JohnWSatterfield/VFO4.1.1/Documents/Atlas Si5351 VFO Schematic Update.PNG

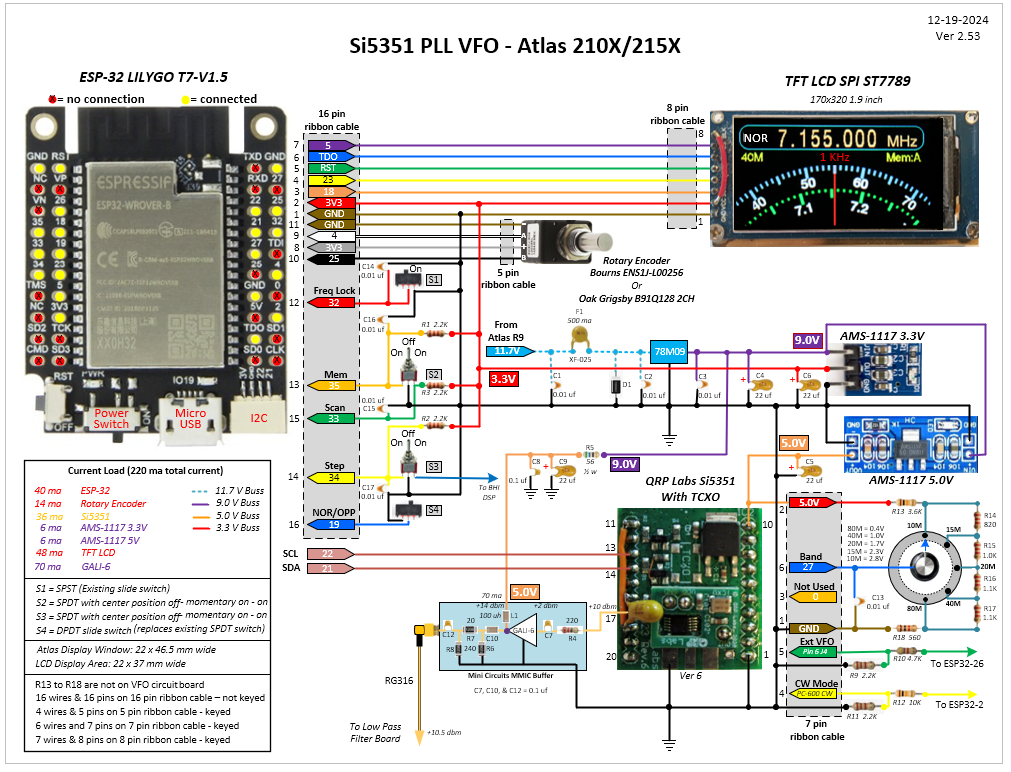
Documents/Atlas Si5351 VFO Schematic Update.PNG
