JohnWSatterfield/VFO4.1.1/Pic/QRP Labs Main LPF Board.jpg

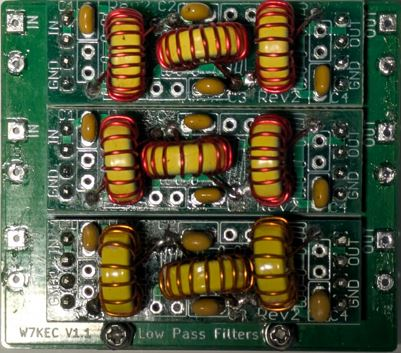
Pic/QRP Labs Main LPF Board.jpg
