JohnWSatterfield/VFO4.1.1/Sketch/VFO Filters.pdf

12V 5V Gnd SKETCH FOR ATLAS 210x FILTERS - 2/05/24 CLK0 CLK1 CLK2 VDD SCLSI5351 module GND SDA VCC Module Regulator 12V TO 5V REG. Vin Vout 270pf C 1.09uh L 560pf C 1.26uh L 560pf C 1.09uh L 270pf C 82pf C 444nh L 220pf C 561uh L 220pf C 444nh L 82pf C 56pf C 303nh L 150pf C 382h L 150pf C 303nh L 56pf C 101112131415Vcc 65432 GND7 DIP 16 1 9 USE ON 80/20m, 40/15m & 10m BANDS LOW PASS FILTERS - 37T-6 TOROID IN GNDIN GNDIN GND GND OUT GND OUT GND OUT 10m BAND 40/15m BANDS 80/20m BANDS P4 - BP CLK0 10m-in 80/20m-in 40/15m-in 10m-IN 40/15m-out MUX1 P6 MUX0 P5 5.0V P11-BP VFO-out 10m-out 80/20m-out 74HCT4052 P15-MUX P14-MUX P12-MUX P2-MUX P5-MUX P1-MUX 3.3V P13-MUX P09-SCL P08-SDA FILTERS FOR ATLAS 210x 40/15m-IN 80/20m-IN GND N/C SCL SDA VCC 3.3V GND Yellow White P09 Yellow P08 White Black RedTINY 12C CLOCK H H Y3 BYPASS L H Y2 10 H L Y1 40/15 L L Y0 80/20 S0 S1 MOX0 MUX1 OUT BAND 28.300 - 22.655 21.300 - 15.655 7.200 - 12.845 3.900 - 9.545 14.250 - 8.605 1 2 11 2 1 2 1 1 MUX 6 7 12 14 Turns L1 L2 10" 10 19 20 Turns L1 L2 1/2" 1/2" 1/2" 5 6" 10 11 Turns L1 L2 1/2" CAR OSC Yellow Red White Red Black White Orange Yellow Red Yellow 2.2 uf .1 uf Yellow FUT INT SCL SDA 3.3V+ GND GND ROTARY SWITCH BAND SELECTOR SDA PFC8574 SCL GND VCC INT P0 P1 P2 P3 P4 P16 (G) White Yellow Black Red Green P8 (W) P9 (Y) 3.3V COM80m 40m 20m 15m10m W G 5" Long O G B R P5 P6 P7 B 74HCT4052 4-CHANNEL MULTIPLEXR Filter Plug Yellow White MUX0 P10MUX1 P9 Black Red Green Orange Yellow White Red Black 3.3V P09-SCL P08-SDA Yellow White P09-SCL P08-SDA NORM SLIDE SWITCH SS-1 OPP SIDEBAND SELECTOR White Wire 40x60 Prototype Bd6 PIN MALE JST 2 PIN MALE JST 2 Pin Male DuPont 16 Pin IC Socket 5 Pin Male DuPont 3 Pin Female DuPont 8 Pin Female DuPont 7 Pin Female DuPont Ceramic Capacitor (12) 37-T6 Toroid (9) 10 K10 K 3.3V
