JohnWSatterfield/VFO4.1.1/Sketch/VFO4.1.1 9.62 C3 Zero.pdf

B 128 p/rev Rotary Enc. GND 1 3 4 2 576 8 OUTSIDE RADIO LOOKING AT SOCKET Internal VFO Radio Ground +9.2 Control In CLK0 To Radio VFO in ESP32-C3 Zero by John Satterfield - KI5IDZ 3.3V 2.0K R GND for software Version VFO4.1.1 04/07/.524 Set Count to 20 9 VFO input to Radio or External VFO in + 9.2V TO 3.3V REG. Vin Vout 9.2V 3.3V Gnd PC-200 Pin 21 - O SKETCH FOR ATLAS 210x DIGITAL VFO (DDS) 3.3V GND 5VESP32-C3 Zero IO07 IO08 IO09 IO10 IO18 IO19 IO20 IO21 IO04 IO02 IO01 IO00 INT (G) SCK (W) TSCL (Y) CS (Bl) MOSI (Y) RS/DC (G) Bottom USB W/O Wire +9.2V VFO (Y) 3.3V To Radio Plug Yellow Yellow Wire Splice BRWY +12V Radio in CW Mode W/Bk Wire Red Wire Splice PC 600 COM NC 5V RELAY1 SIG 5V NO GND RADIO Future R 2.2K GND R 4.7K P01 Red P19 Yellow 10K R P Black (future) BRWY Filter Plug Radio Plug Scan Step Memory GND on (off) on P02 YellowSwitch Plug P04 P20 BRWY P03 Yellow GND Switch Plug P05 Black Red White A Black Red White Black Red White Yellow Black Red White Yellow Future FUT INT SCL SDA 3.3V+ GND GND Red Black Gnd Green Orange Yellow White IO05 IO06 IO03 TSDA(W) Scan (R) LOCK (W) ENC B (Y) Step (W) ENC A (W) MEM (Y) CW+ (R) 3.3V GND LED SCK RES CS VCC 3.3V ST7735 (128X160) TFT LCD 12345678 MOSI P06 P10 3.3V P09 Black Red White Yellow Orange Green Blue Violet 1.77 Inch SCK SDA/MOSI RS/DC CS RS P18 30x70 Prototype Bd (TOP) A B C D E F G H I J K L M N O P Q R S T U V W X9 7 10 5 8 3 6 2 1 4 30x70 Prototype Bd (BOTTOM) A B C D E F G H I J K L M N O P Q R S T U V W X9 7 10 5 8 3 6 2 1 4
