JohnWSatterfield/VFO4.1.1/Documents/10M LPF.JPG

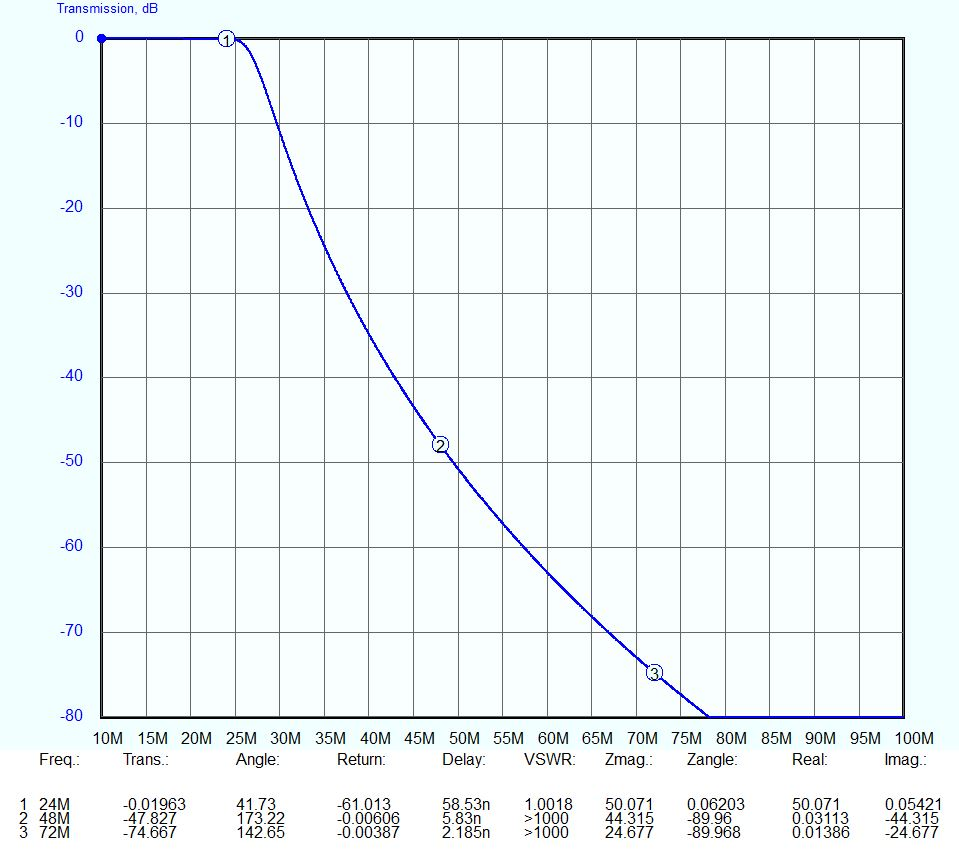
Documents/10M LPF.JPG
