JohnWSatterfield/VFO4.1.1/Documents/40M-15M LPF.JPG

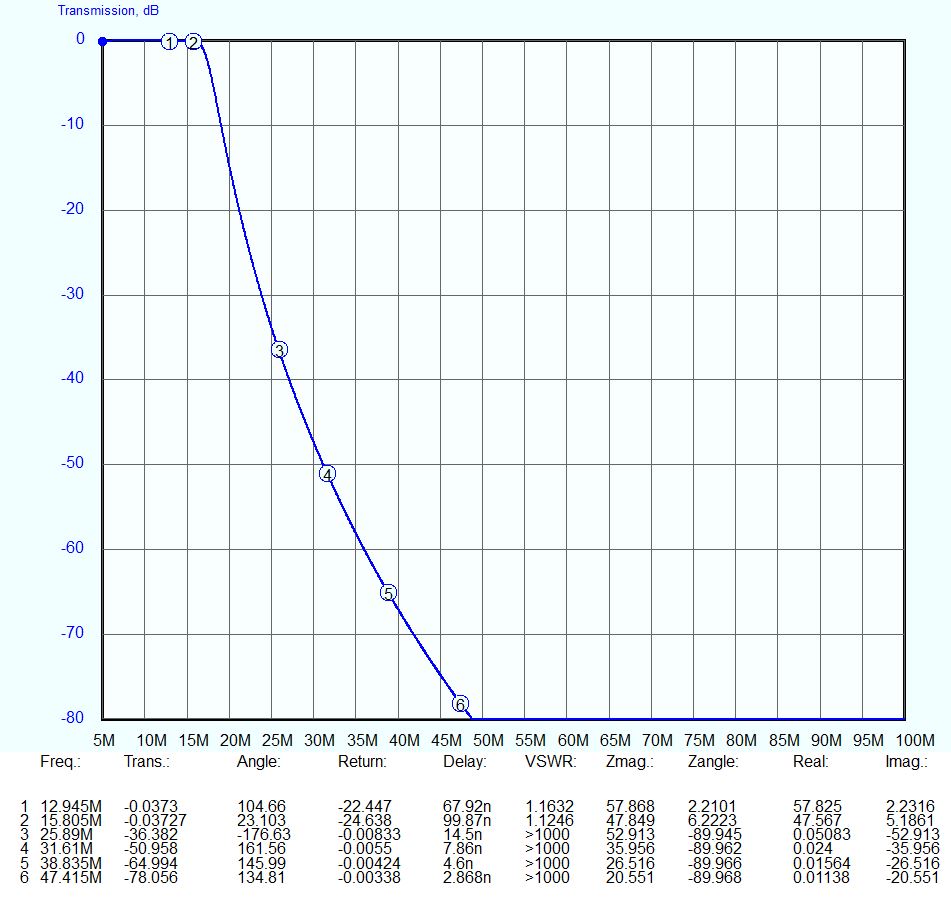
Documents/40M-15M LPF.JPG
