JohnWSatterfield/VFO4.1.1/Documents/160M-80M-20M LPF.JPG

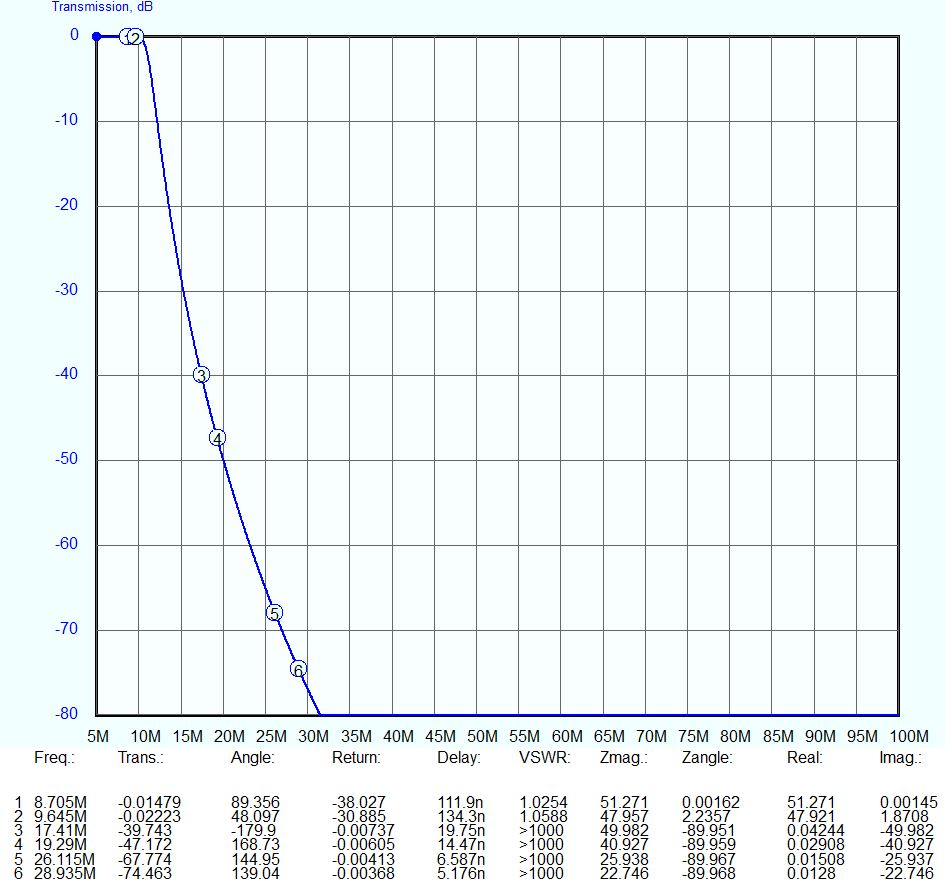
Documents/160M-80M-20M LPF.JPG
