JohnWSatterfield/VFO4.1.1/Pic/210X LE Front Panel Labels.jpg

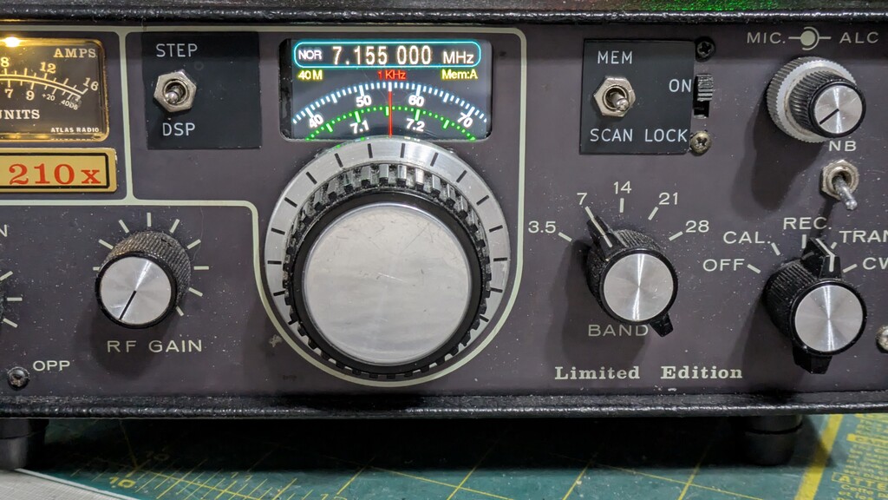
Pic/210X LE Front Panel Labels.jpg
