JohnWSatterfield/VFO4.1.1/Pic/JLCPCB Ciruit Boards.jpg

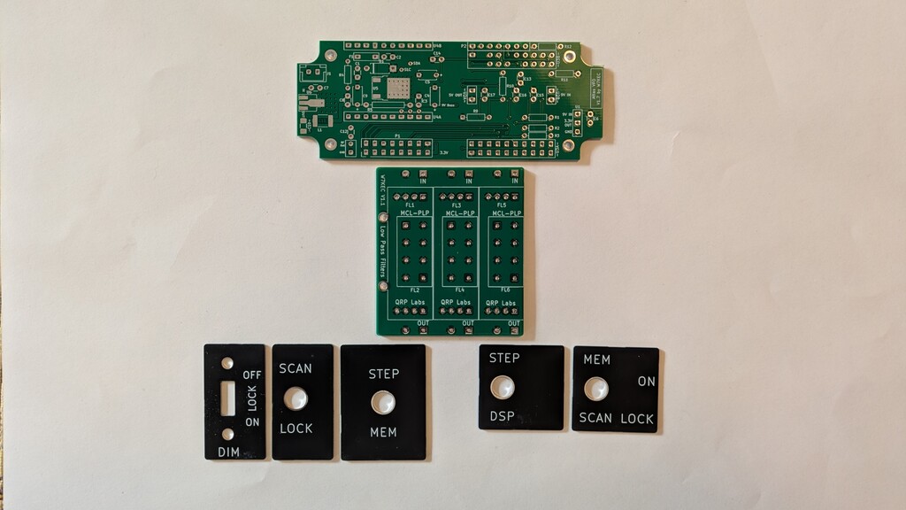
Pic/JLCPCB Ciruit Boards.jpg
