JohnWSatterfield/VFO4.1.1/Sketch/ESP32 D1 Mini.pdf

# CLK0 CLK1

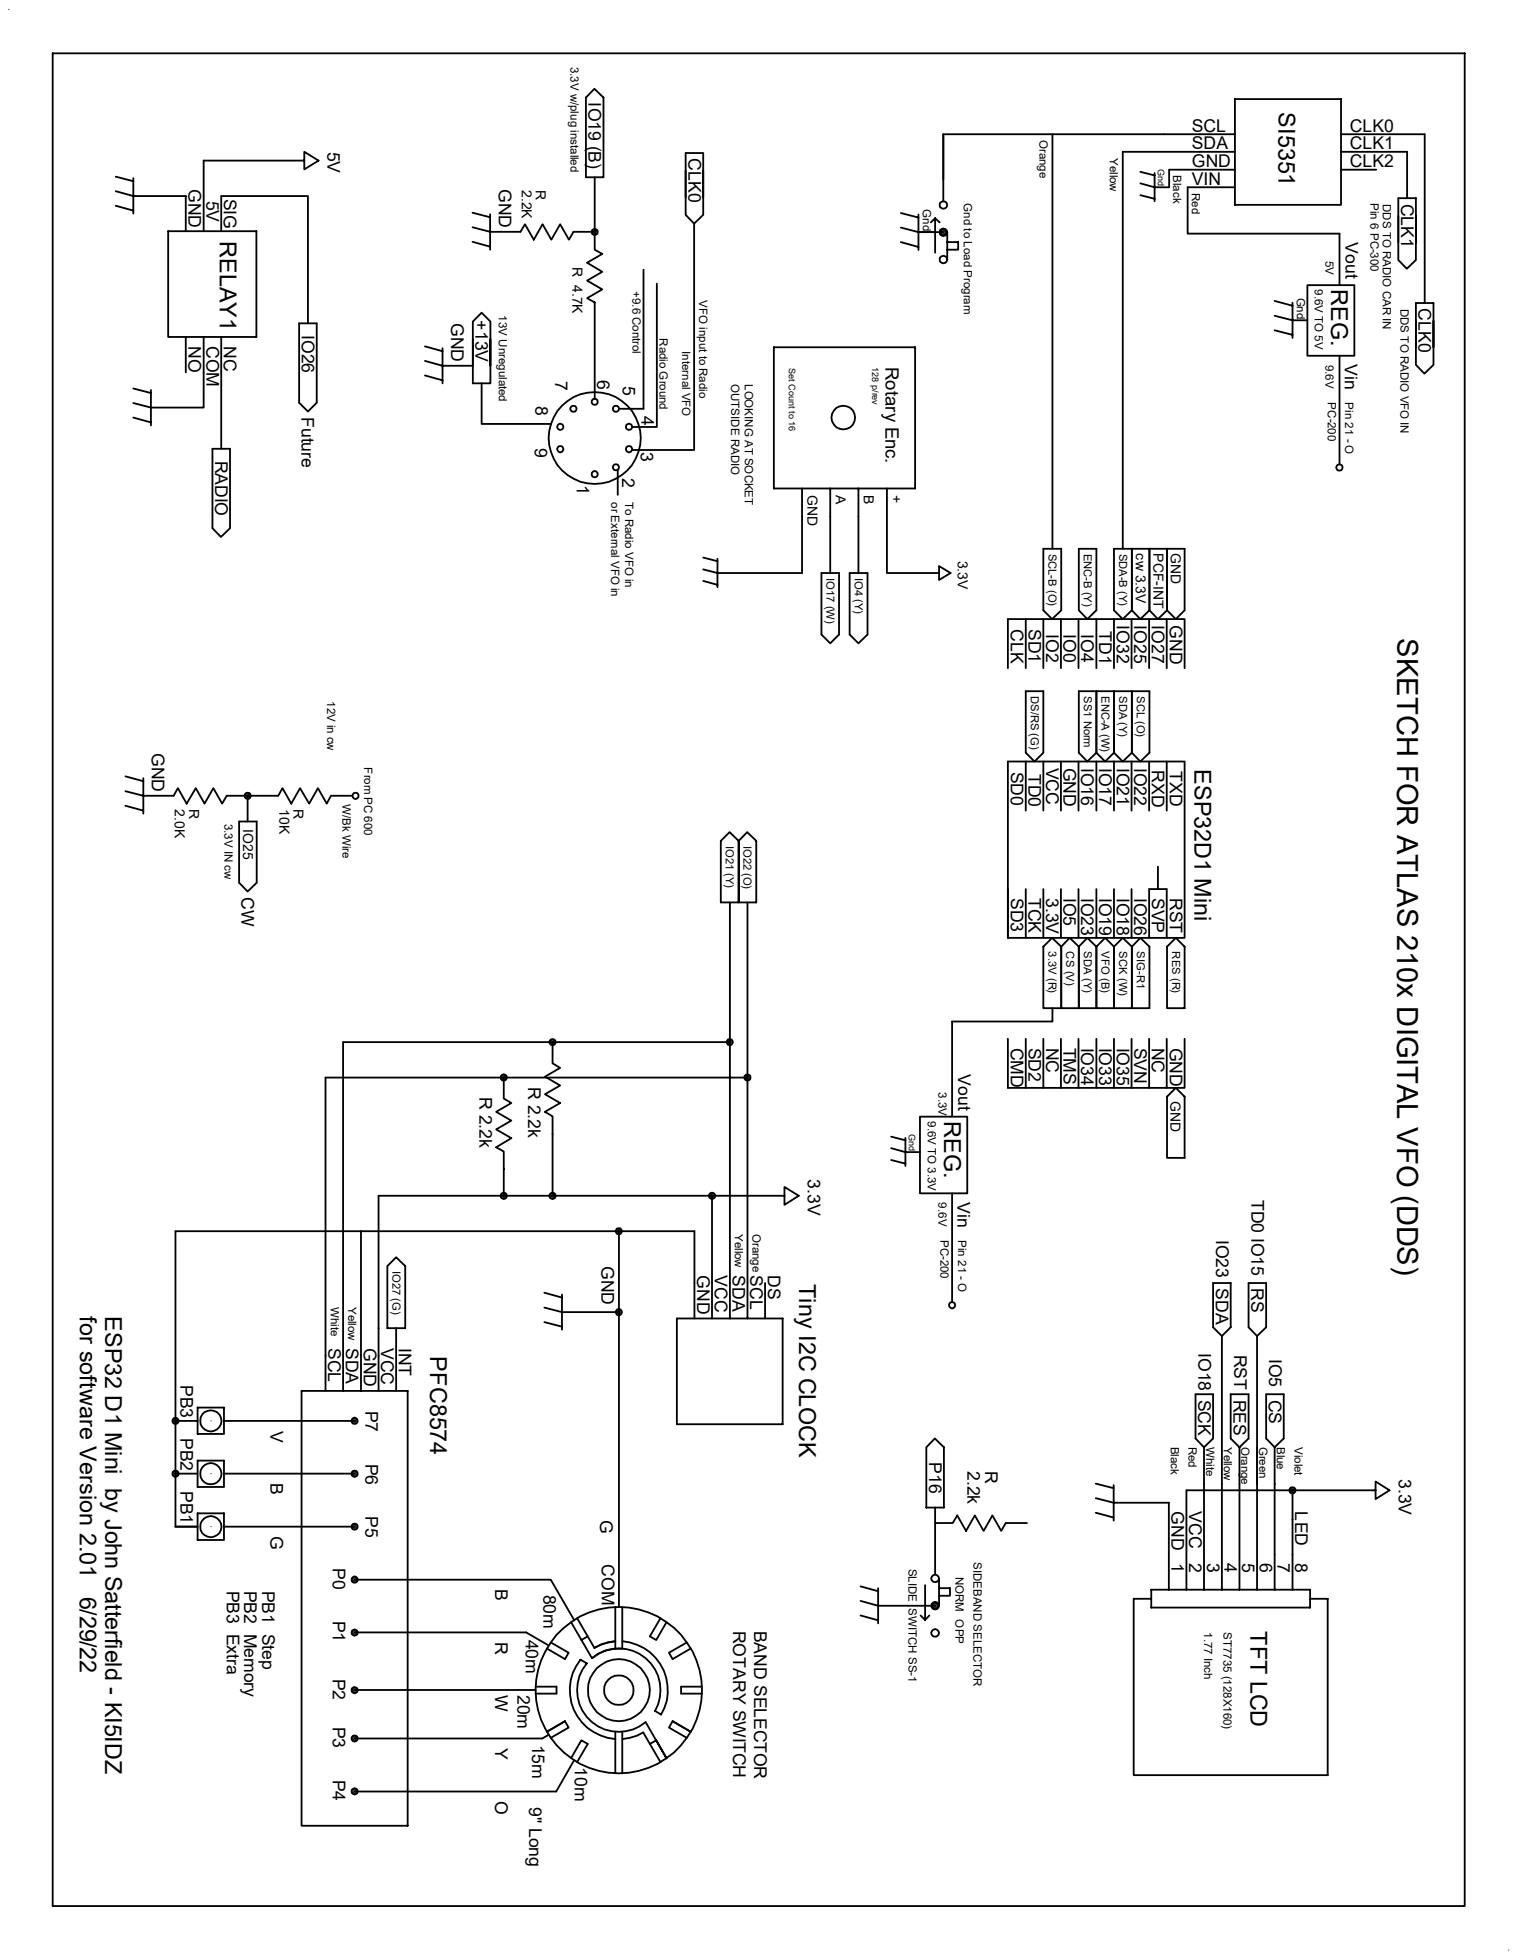
[picture p8: page 1]

8 R 4.7K GND 2.2K R IO19 (B) 3.3V w/plug installed +13V 13V Unregulated GND OUTSIDE RADIO LOOKING AT SOCKET Internal VFO Radio Ground +9.6 Control IO18 IO23 RST TD0 IO15 IO5 GND

8 SDA RS SDA Tiny I2C CLOCK VCC SCL GND COM NC 5V RELAY1 SIG 5V NO IO26 GND RADIO 1

+ Pin 6 PC-300 9.6V TO 3.3V REG. Vin Vout 9.6V 3.3V Gnd PC-200 Pin 21 - O SKETCH FOR ATLAS 210x DIGITAL VFO (DDS) Gnd to Load Program Gnd IO26 SVP RST ESP32D1 Mini Yellow IO27 GND cw 3.3V PCF-INT IO32 IO25 CLK SD1 IO2 IO0 IO4 TD1 SD0 TD0 VCC GND IO16 IO17 IO21 IO22 RXD TXD SD3 TCK 3.3V IO5 IO23 IO19 IO18 CMD SD2 NCTMS IO34 IO33 IO35 SVN NCGND SCL-B (O) SDA-B (Y) GND ENC-A (W) SDA (Y) SCL (O) CS (V) SDA (Y) SCK (W) RES (R) DS/RS (G) GND ENC-B (Y) SS1 Norm 3.3V (R) VFO (B) SIG-R1 Gnd Orange Red Black IO17 (W) IO4 (Y) IO21 (Y) IO22 (O) CW IO27 (G)

9 From PC 600 W/Bk Wire VFO input to Radio or External VFO in 9.6V TO 5V REG. Vin Vout 9.6V 5V Gnd PC-200 Pin 21 - O 2.2k R

B 128 p/rev Rotary Enc. GND LED SCK RES CS VCC 3.3V ST7735 (128X160) TFT LCD
