JohnWSatterfield/VFO4.1.1/Sketch/VFO4.1.1 9.62 RP2040 Zero.pdf

B
R

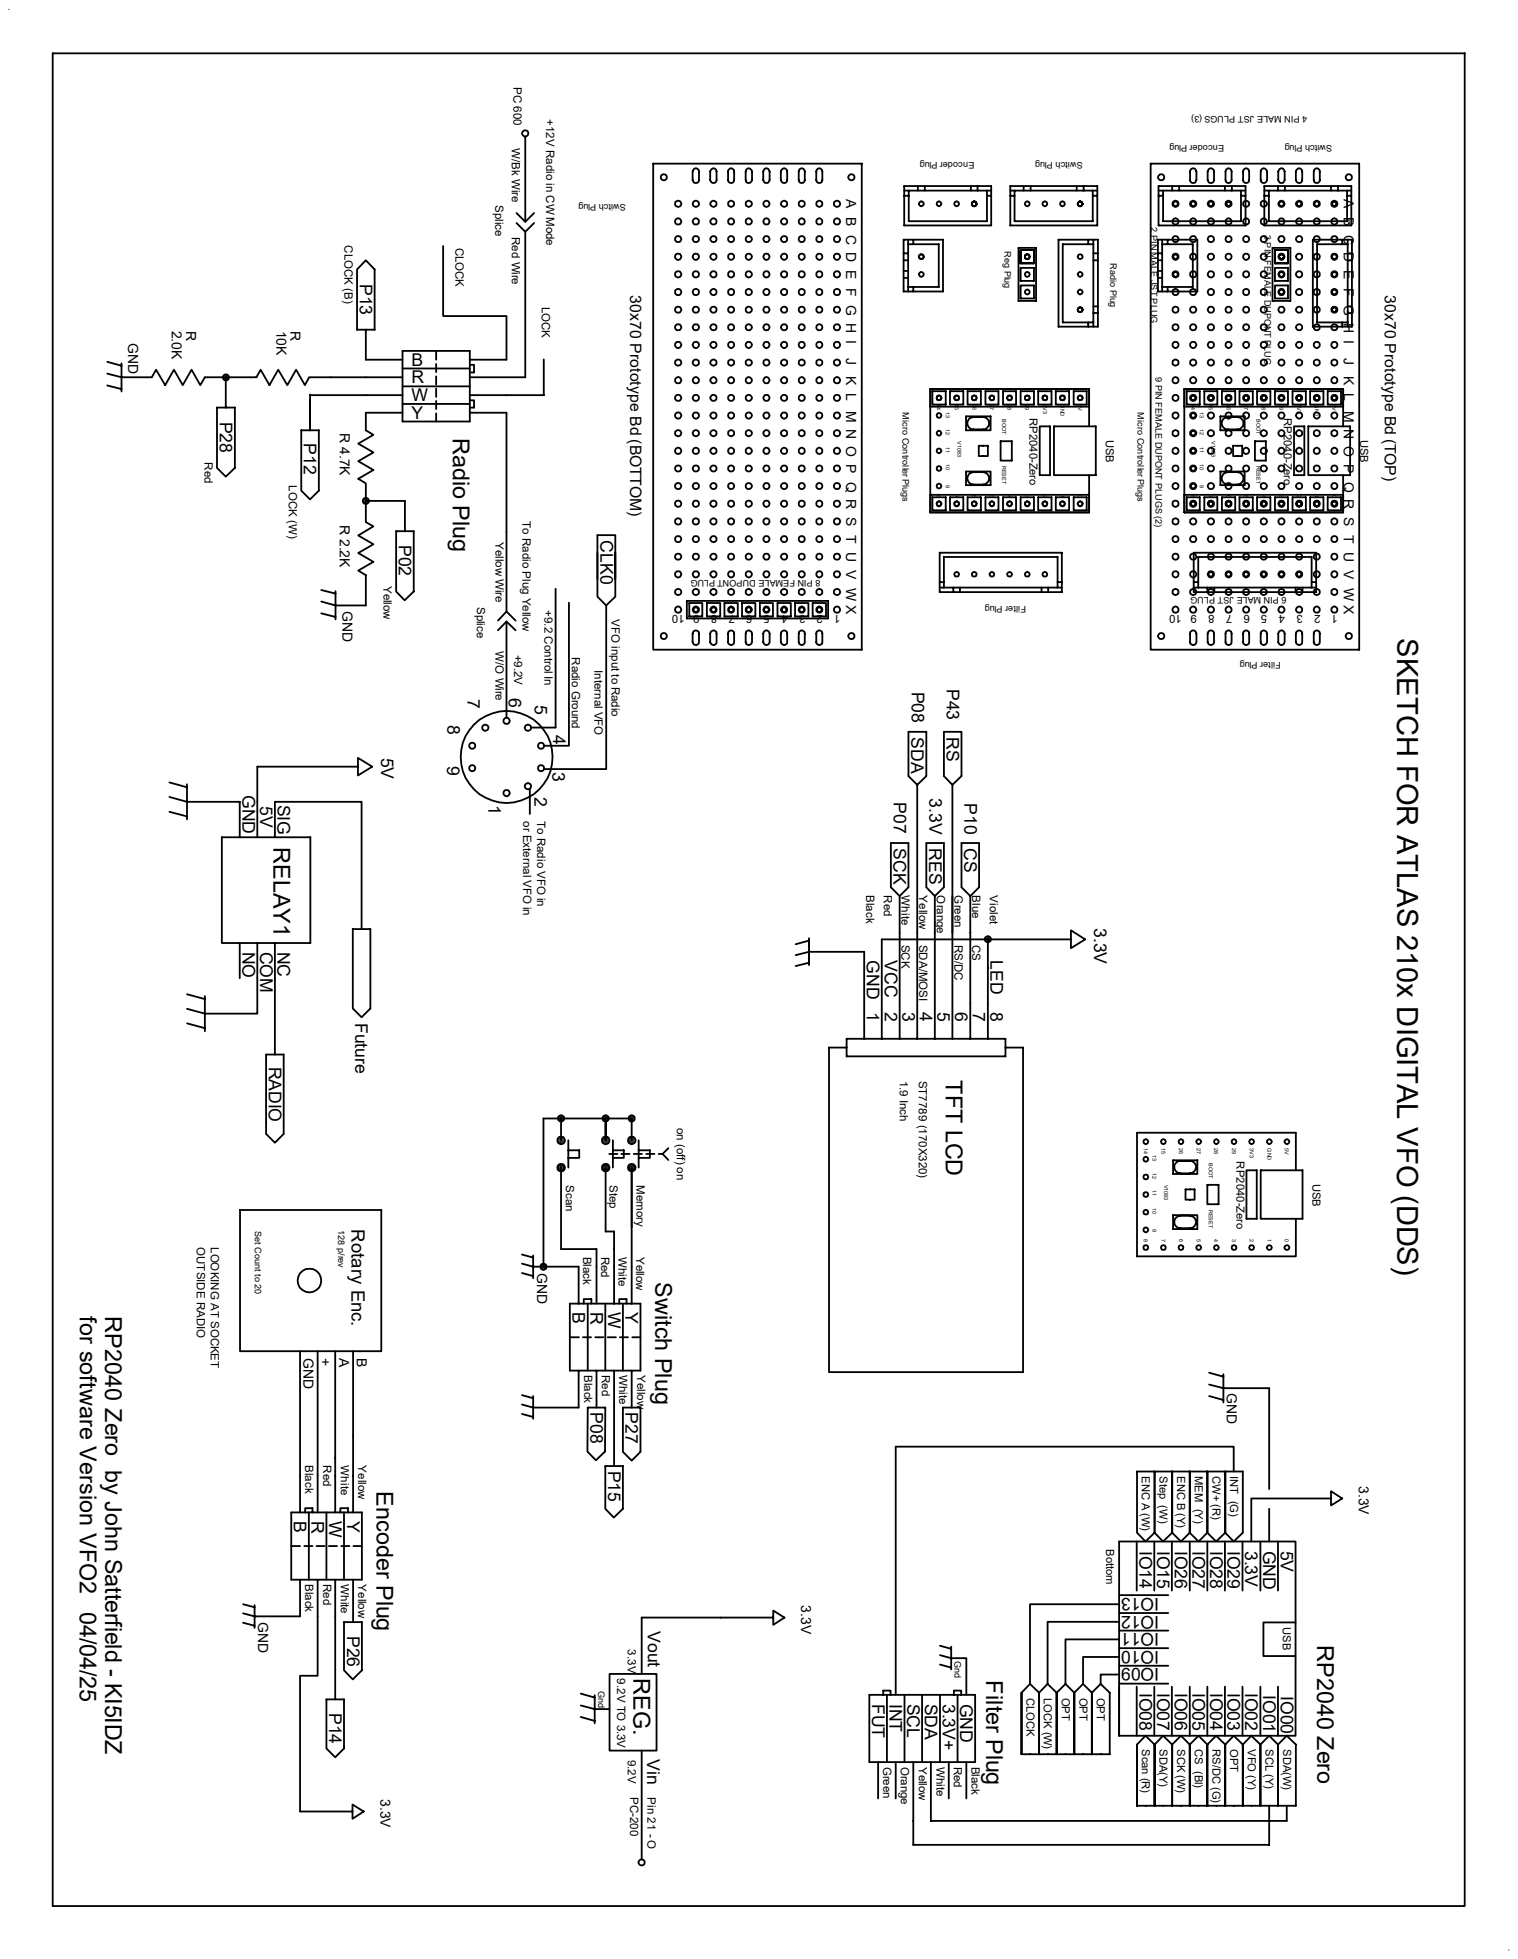
[picture p9: page 1]

8 SDA P07 P08 3.3V P10 Black Red White Yellow Orange Green Blue Violet 1.9 Inch SCK SDA/MOSI RS/DC CS RS P43 30x70 Prototype Bd (TOP) A B C D E F G H I J K L M N O P Q R S T U V W X

Y P14 Yellow GND Encoder Plug P26 Black Red White A Black Red White Black Red White Yellow Black Red White Yellow CLOCK FUT INT SCL SDA 3.3V+ GND GND Red Black Gnd Green Orange Yellow White IO14 IO08 IO26 Scan (R) SDA(W) LOCK (W) ENC A (W) Step (W) ENC B (Y) MEM (Y) CW+ (R) 3.3V GND LED SCK RES CS VCC 3.3V ST7789 (170X320) TFT LCD

8 OUTSIDE RADIO LOOKING AT SOCKET Internal VFO Radio Ground +9.2 Control In CLK0 To Radio VFO in RP2040 Zero by John Satterfield - KI5IDZ 3.3V 2.0K R GND for software Version VFO2 04/04/25 Set Count to 20

0 13 12 11 10 9 V1083 USB BOOT RESET RP2040-Zero 1415262728293V3 GND 5V

Y Filter Plug Radio Plug Scan Step Memory GND on (off) on P27 YellowSwitch Plug P15 P08 BRW

9 VFO input to Radio or External VFO in + 9.2V TO 3.3V REG. Vin Vout 9.2V 3.3V Gnd PC-200 Pin 21 - O SKETCH FOR ATLAS 210x DIGITAL VFO (DDS) 3.3V GND 5V RP2040 Zero IO07 IO06 IO05 IO04 IO03 IO02 IO01 IO00 IO15 IO27 IO28 IO29 INT (G) SCK (W) CS (Bl) RS/DC (G) SCL (Y) Bottom USB W/O Wire +9.2V VFO (Y) 3.3V To Radio Plug Yellow Yellow Wire Splice

B 128 p/rev Rotary Enc. GND
