JohnWSatterfield/VFO4.1.1/Sketch/VFO4.1.1 9.62 S3 Mini.pdf

B
R

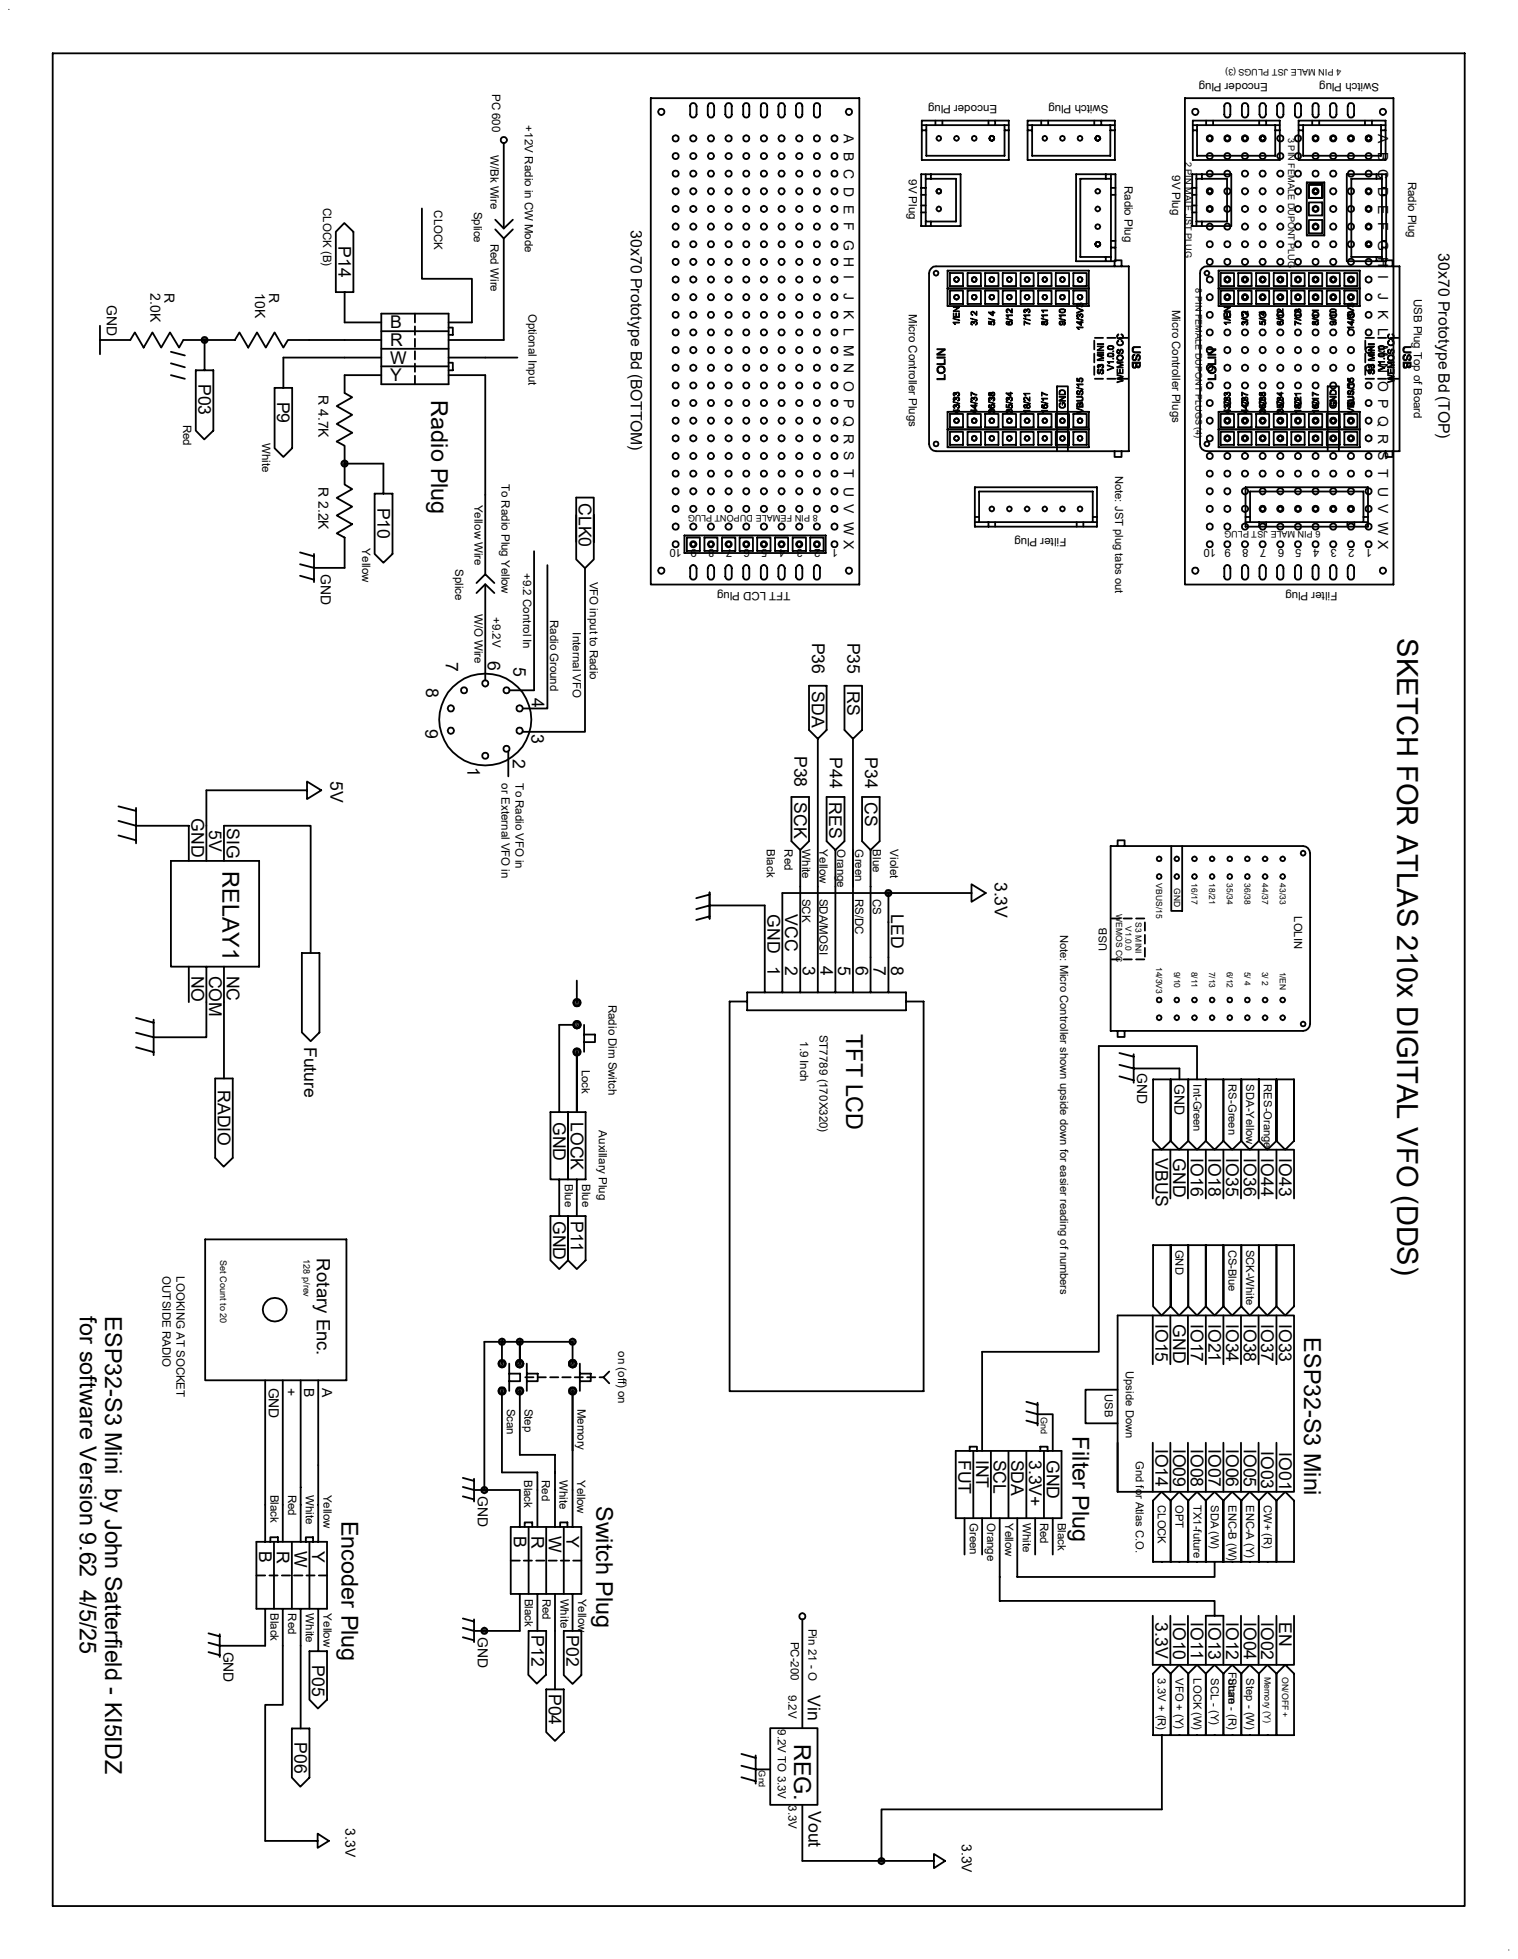
[picture p11: page 1]

8 SDA P38 P36 P44 P34 Black Red White Yellow Orange Green Blue Violet 1.9 Inch SCK SDA/MOSI RS/DC CS RS P35 CLOCK Lock P11 Auxillary Plug Blue LOCK GND Blue GND Radio Dim Switch Radio Plug 9V Plug Switch Plug Encoder Plug

Y P05 Yellow GND Encoder Plug P06 Black Red White B Black Red White Black Red White Yellow Black Red White Yellow CLOCK FUT INT SCL SDA 3.3V+ GND GND Red Black Gnd Green Orange Yellow White Optional Input 30x70 Prototype Bd (TOP) A B C D E F G H I J K L M N O P Q R S T U V W X

8 OUTSIDE RADIO LOOKING AT SOCKET Internal VFO Radio Ground +9.2 Control In CLK0 To Radio VFO in P9 ESP32-S3 Mini by John Satterfield - KI5IDZ 3.3V 2.0K RGND for software Version 9.62 4/5/25 Set Count to 20

Y Filter Plug Radio Plug Scan Step Memory GND on (off) on P02 Yellow GND Switch Plug P04 P12 BRW

9 VFO input to Radio or External VFO in + REG. 9.2V TO 3.3V Vin Vout 9.2V 3.3V Gnd Pin 21 - O PC-200 SKETCH FOR ATLAS 210x DIGITAL VFO (DDS) IO38 IO37 IO33 ESP32-S3 Mini EN IO08 IO07 IO06 IO05 IO03 IO01 IO04 IO02 IO14 IO09 IO15 GND IO17 IO21 IO34 VBUS GND IO16 IO18 IO35 IO36 IO44 IO43 GND CS-Blue SCK-White OPT TX1-future SDA (W) ENC-B (W) ENC-A (Y) 3.3V + (R) LOCK (W) Scan - (R) Step - (W) Memory (Y) GND SDA-Yellow Upside Down USB White W/O Wire +9.2V 3.3V IO10 IO11 IO13 IO12 RS-Green RES-Orange CW+ (R) VFO + (Y) SCL - (Y) ON/OFF + Gnd for Atlas C.O. Future Int-Green 3.3V To Radio Plug Yellow Yellow Wire Splice

A 128 p/rev Rotary Enc. GND
