JohnWSatterfield/VFO4.1.1/Sketch/VFO4.1.1 9.62 S3 R8N16.pdf

B
R

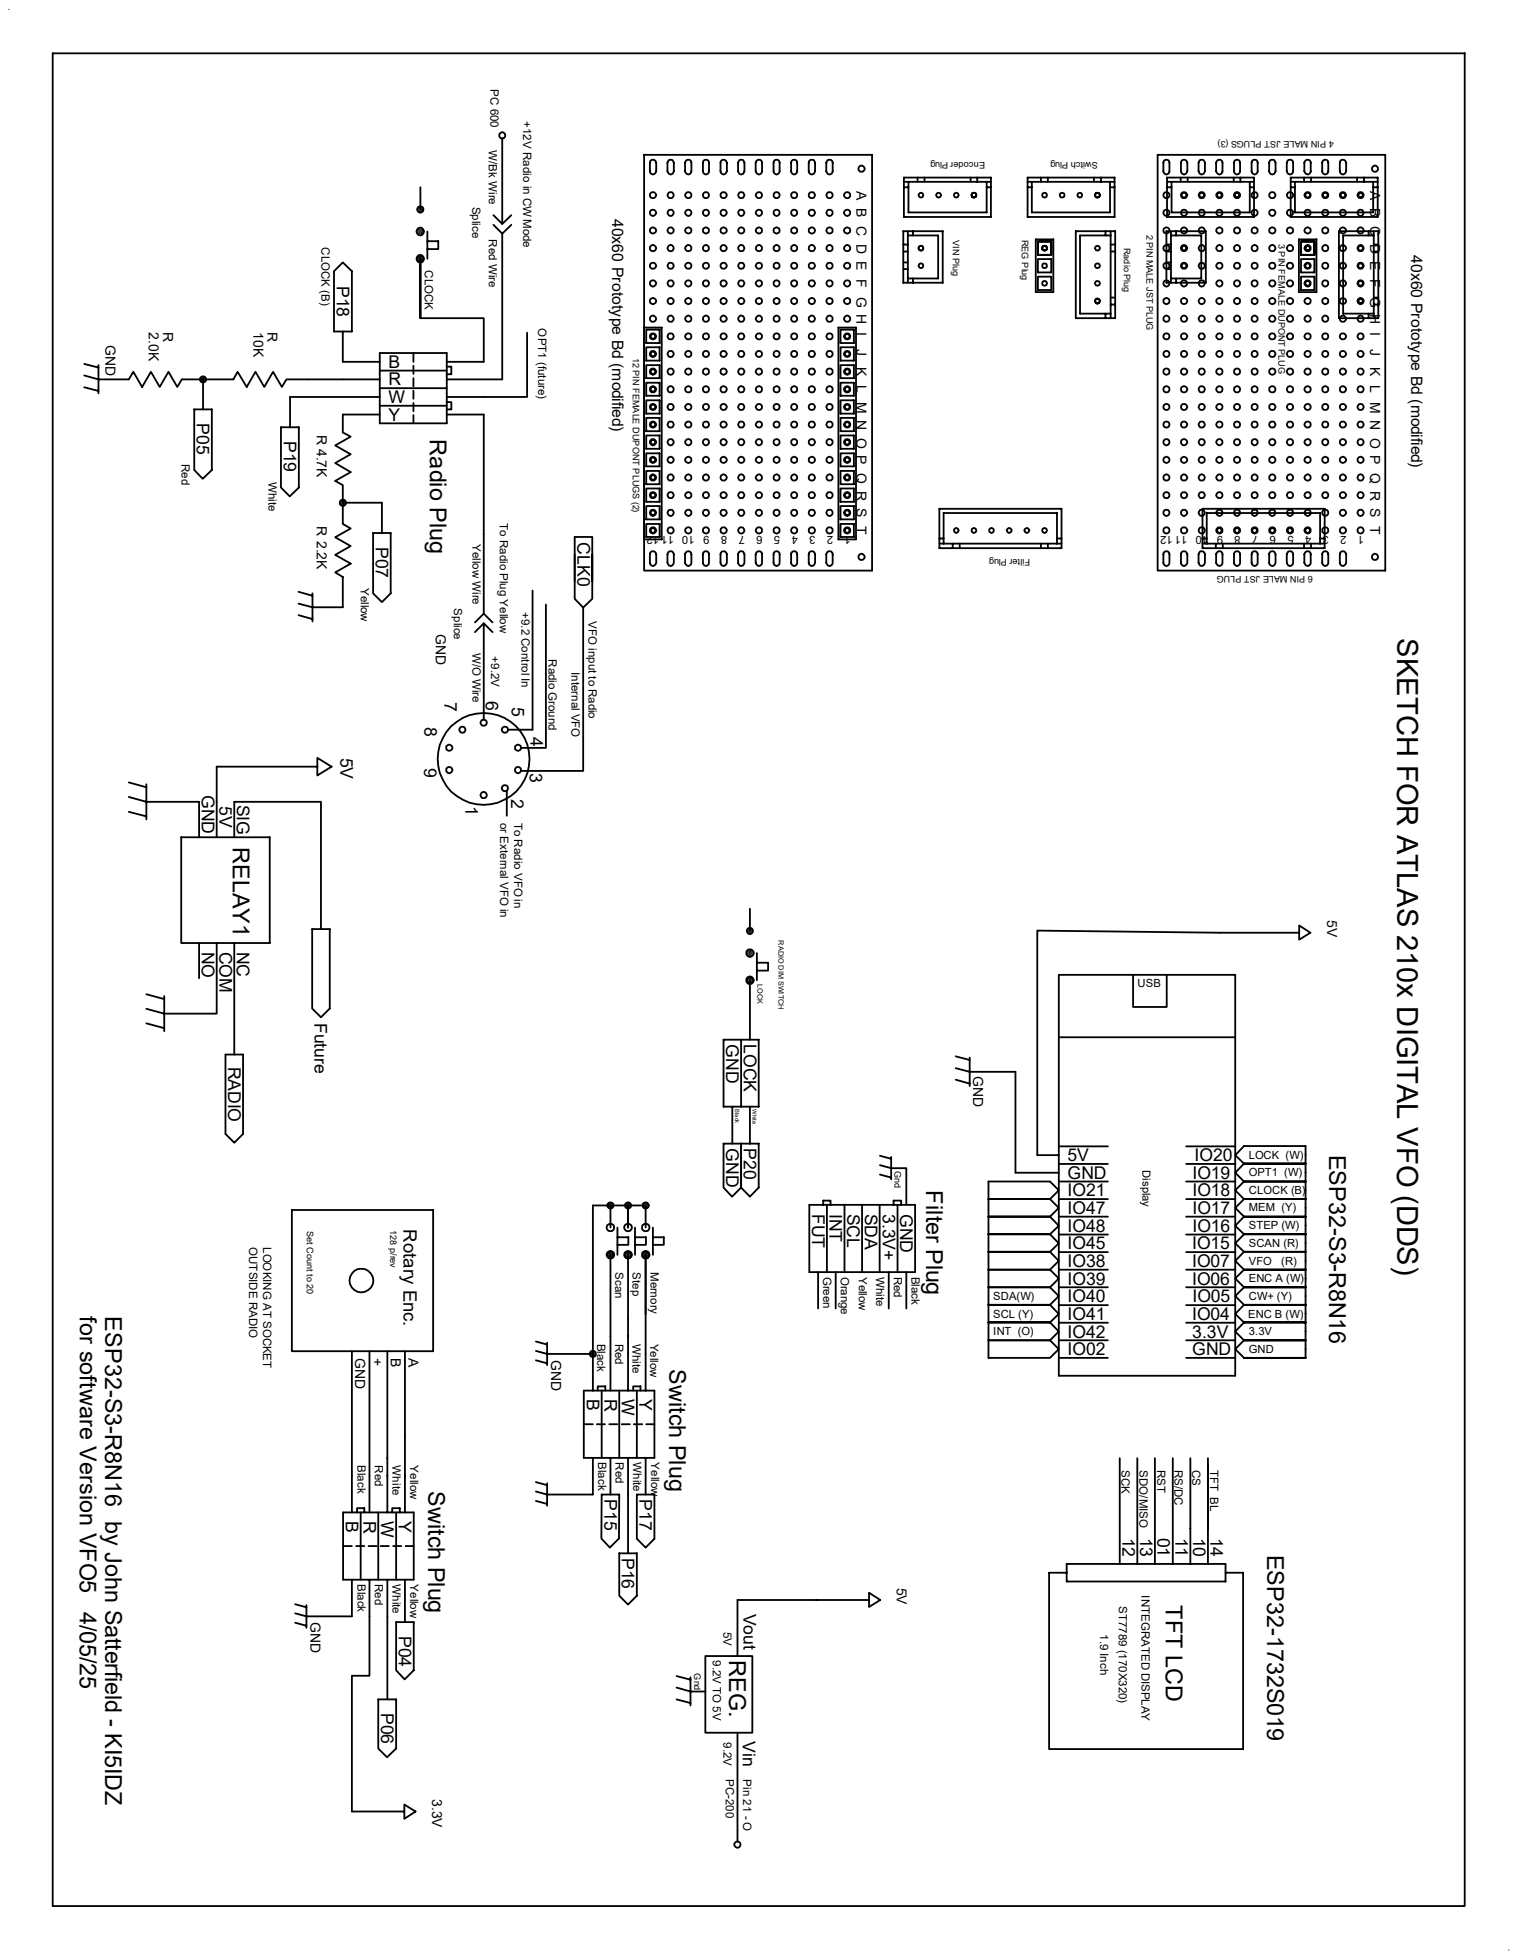
[picture p12: page 1]

8 OUTSIDE RADIO LOOKING AT SOCKET Internal VFO Radio Ground +9.2 Control In CLK0 To Radio VFO in ESP32-S3-R8N16 by John Satterfield - KI5IDZ3.3V 2.0K R GND for software Version VFO5 4/05/25 Set Count to 20

Y Filter Plug Radio Plug Scan Step Memory GND P17 YellowSwitch Plug P16 P15BRW

9 VFO input to Radio or External VFO in + 9.2V TO 5V REG. Vin Vout 9.2V 5V Gnd PC-200 Pin 21 - O SKETCH FOR ATLAS 210x DIGITAL VFO (DDS) 5V

Y P04 Yellow GND Switch Plug P06 Black Red WhiteA Black Red White Black Red White Yellow Black Red White Yellow FUT INT SCL SDA 3.3V+ GND GND Red Black Gnd Green Orange Yellow WhiteIO40

B 128 p/rev Rotary Enc. GND
