JohnWSatterfield/VFO4.1.1/Sketch/VFO4.1.1 9.62 S3 ZERO.pdf

B
R

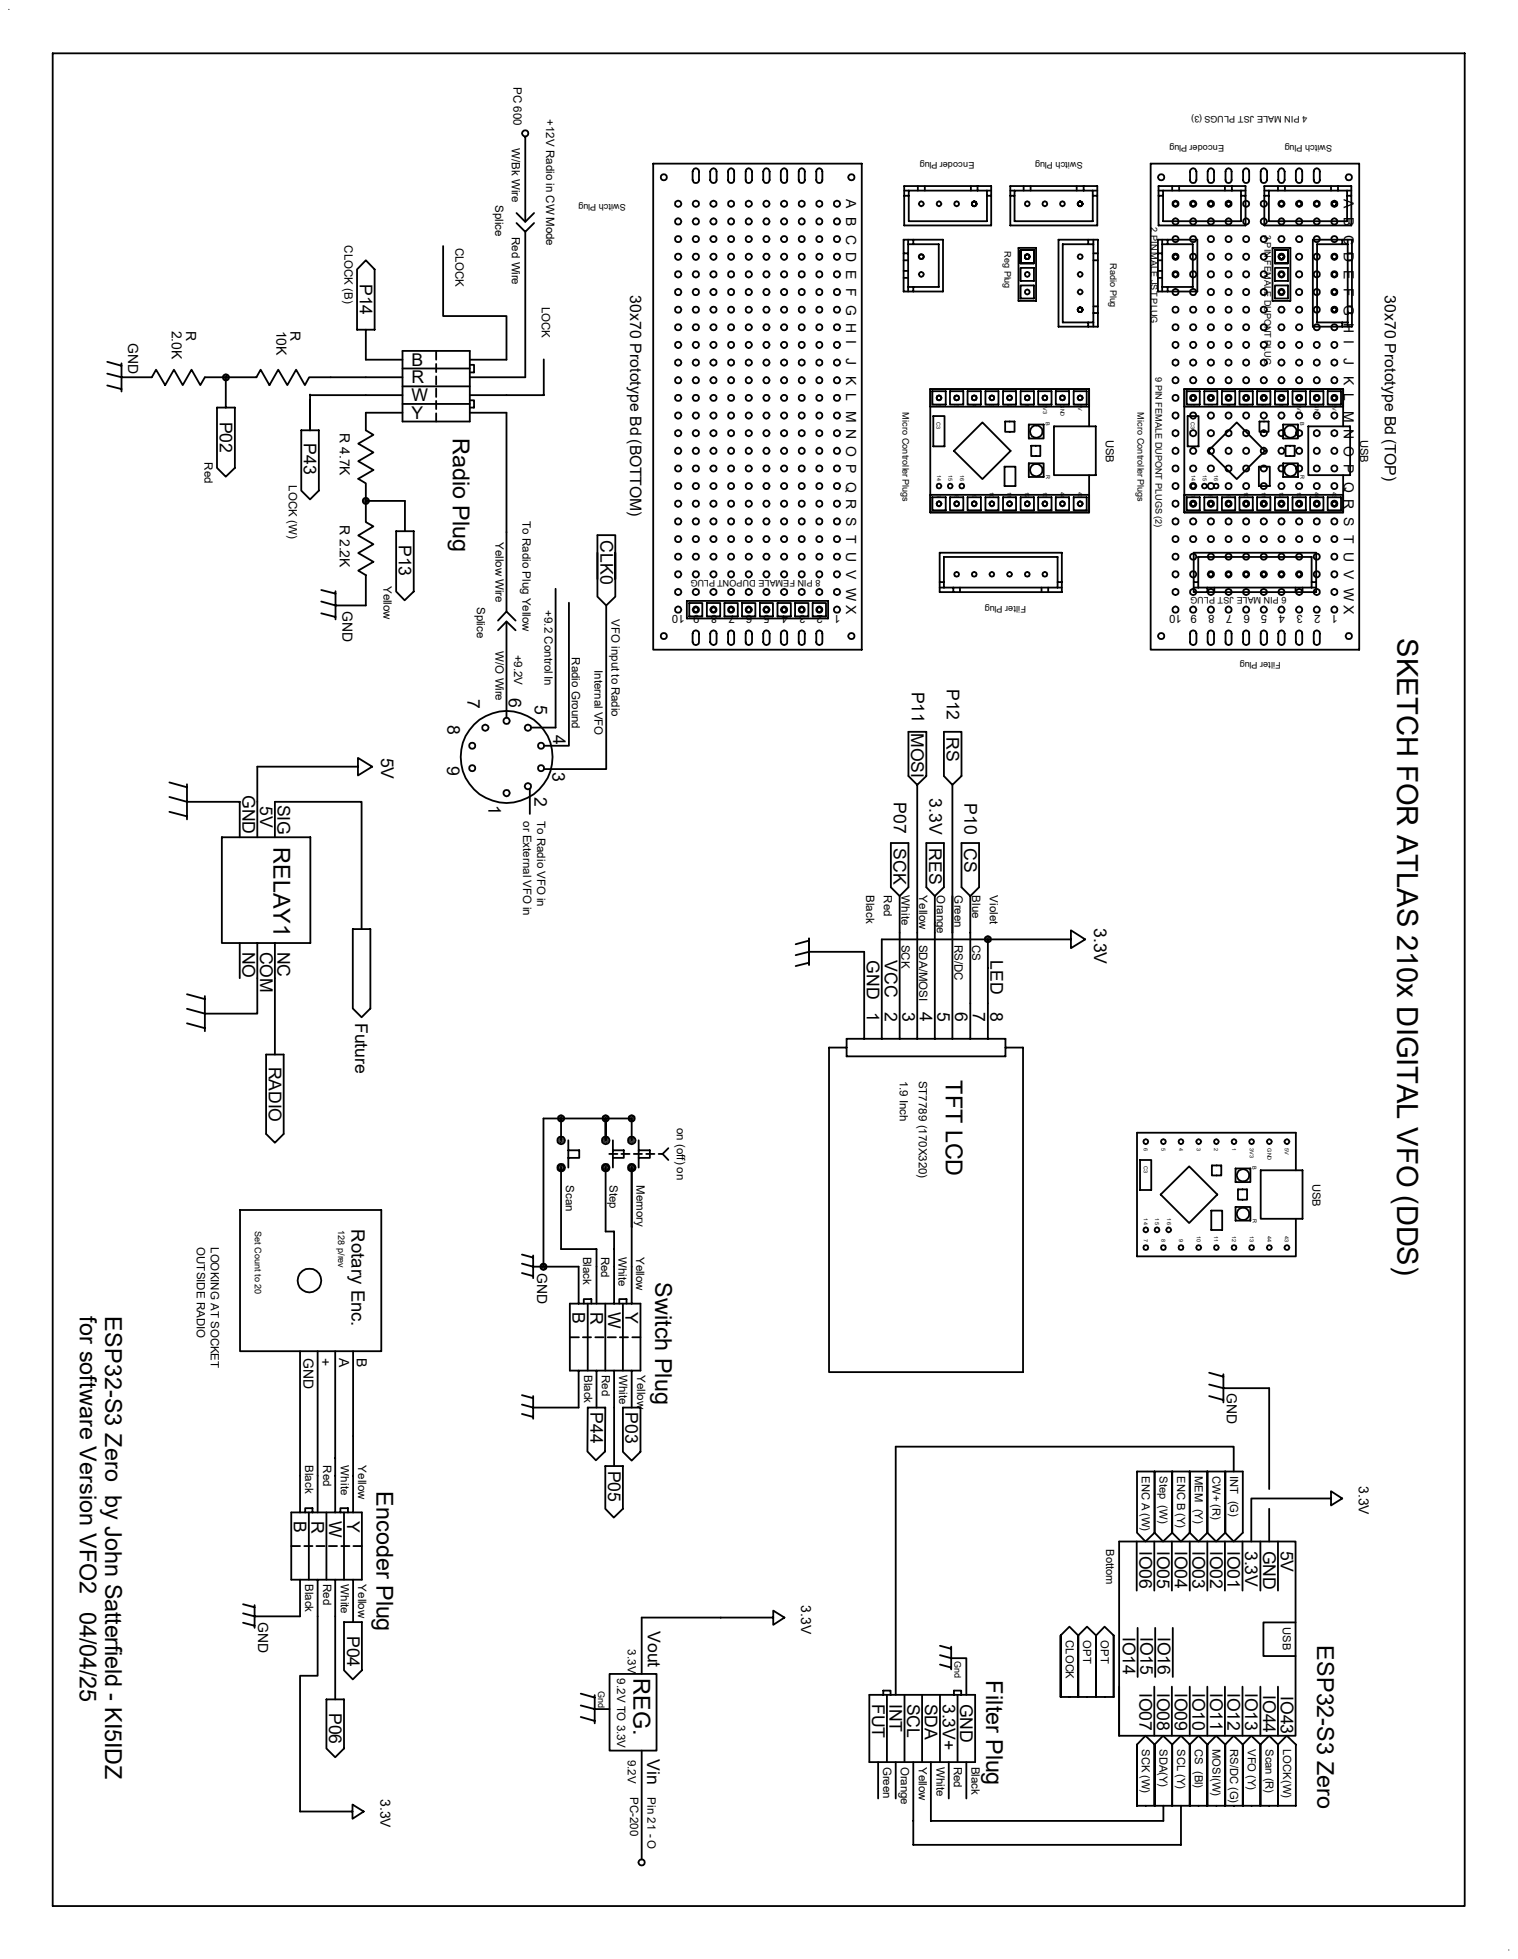
[picture p13: page 1]

9 14 USB C3 1516 Switch Plug Switch Plug Encoder Plug Radio Plug Reg Plug Filter Plug Micro Controller Plugs

8 MOSI P07 P11 3.3V P10 Black Red White Yellow Orange Green Blue Violet 1.9 Inch SCK SDA/MOSI RS/DC CS RS P12 30x70 Prototype Bd (TOP) A B C D E F G H I J K L M N O P Q R S T U V W X

Y P06 Yellow GND Encoder Plug P04 Black Red White A Black Red White Black Red White Yellow Black Red White Yellow CLOCK FUT INT SCL SDA 3.3V+ GND GND Red Black Gnd Green Orange Yellow White IO06 IO07 IO04 Scan (R) LOCK(W) OPT ENC A (W) Step (W) ENC B (Y) MEM (Y) CW+ (R) 3.3V GND LED SCK RES CS VCC 3.3V ST7789 (170X320) TFT LCD

8 OUTSIDE RADIO LOOKING AT SOCKET Internal VFO Radio Ground +9.2 Control In CLK0 To Radio VFO in ESP32-S3 Zero by John Satterfield - KI5IDZ 3.3V 2.0K R GND for software Version VFO2 04/04/25 Set Count to 20

Y Filter Plug Radio Plug Scan Step Memory GND on (off) on P03 YellowSwitch Plug P05 P44 BRW

9 VFO input to Radio or External VFO in + 9.2V TO 3.3V REG. Vin Vout 9.2V 3.3V Gnd PC-200 Pin 21 - O SKETCH FOR ATLAS 210x DIGITAL VFO (DDS) 3.3V GND 5V ESP32-S3 Zero IO08 IO09 IO10 IO11 IO12 IO13 IO44 IO43 IO05 IO03 IO02 IO01 INT (G) SCK (W) SCL (Y) CS (Bl) RS/DC (G) Bottom USB W/O Wire +9.2V VFO (Y) 3.3V To Radio Plug Yellow Yellow Wire Splice

B 128 p/rev Rotary Enc. GND
