JohnWSatterfield/VFO4.1.1/Sketch/VFO4.1.1 9.62 WROOM.pdf

B
R

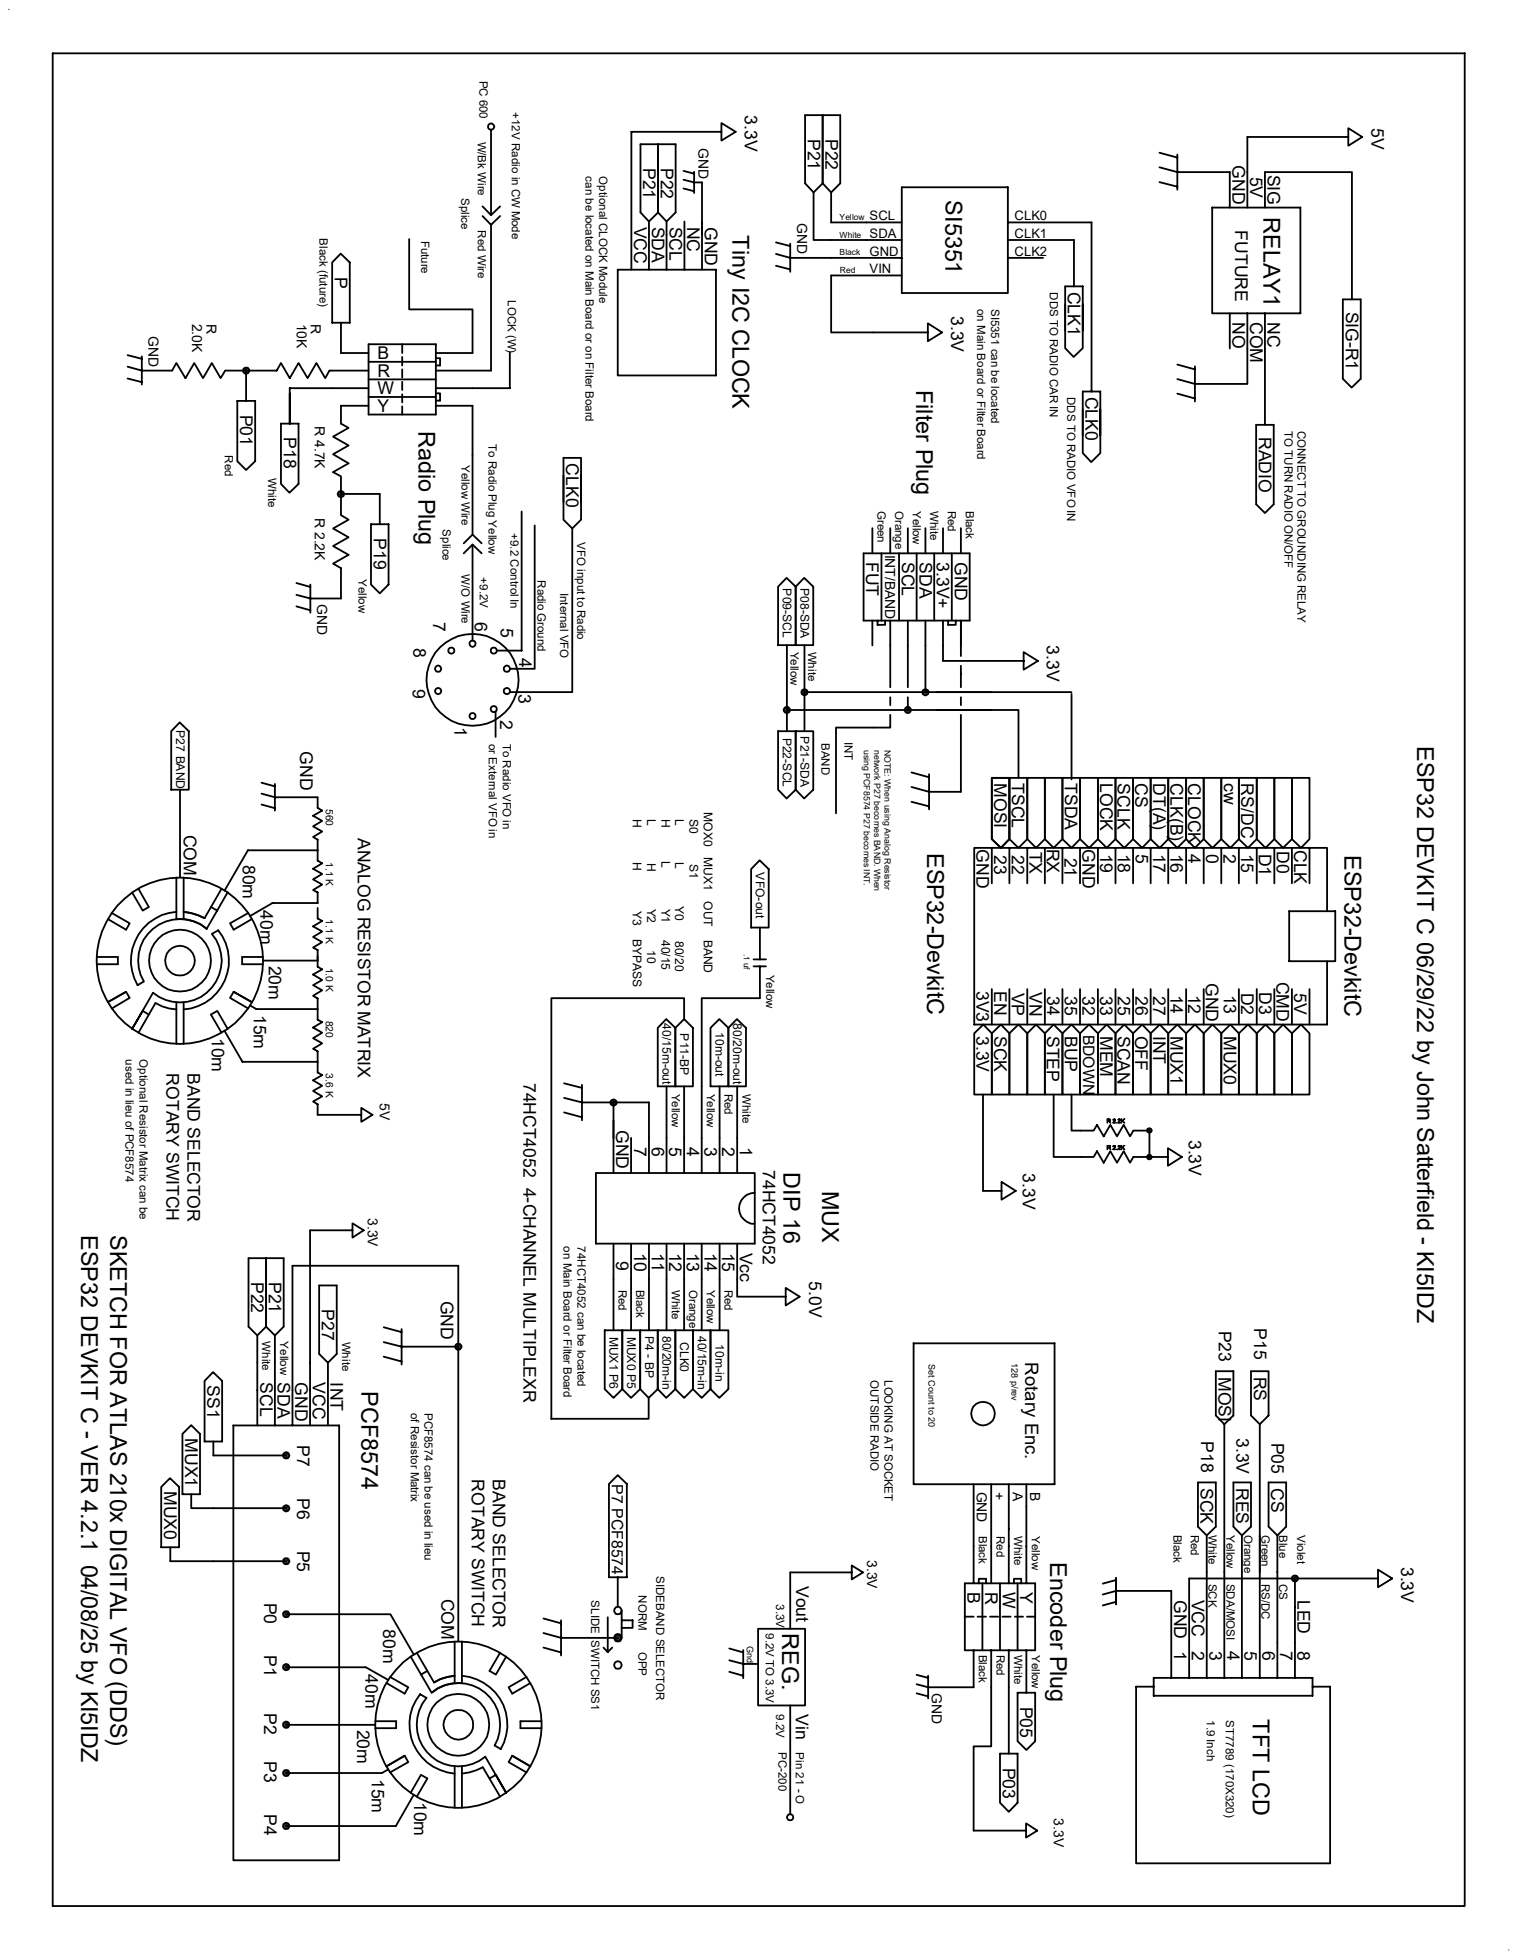
[picture p14: page 1]

8 MOSI P18 P23 3.3V P05 Black Red White Yellow Orange Green Blue Violet 1.9 Inch SCK SDA/MOSI RS/DC CS RS P15 SDA PCF8574 SCL GND VCC GND COM80m 40m 20m 15m10m ROTARY SWITCH BAND SELECTOR INT P27 P0 P1 P2 P3 P4 P5 P6 P7 White Yellow White 3.3V SS1 MUX0 MUX1 P22 P21 of Resistor Matrix PCF8574 can be used in lieu SDA Tiny I2C CLOCK VCC SCL GND 3.3V P21 P22 GND NC can be located on Main Board or on Filter Board Optional CLOCK Module

P Black (future) Radio Plug Future LOCK (W) P18 White GND LED SCK RES CS VCC 3.3V ST7789 (170X320) TFT LCD

8 Internal VFO Radio Ground +9.2 Control In CLK0 To Radio VFO in 2.0K R GND

9 P4 - BP CLK0 10m-in 80/20m-in 40/15m-in 40/15m-out MUX1 P6 MUX0 P5 5.0V P11-BP VFO-out 10m-out 80/20m-out 74HCT4052 H H Y3 BYPASS L H Y2 10 H L Y1 40/15 L L Y0 80/20 S0 S1 MOX0 MUX1 OUT BAND MUX Yellow Red White Red Black White Orange Yellow Red Yellow .1 uf Yellow 74HCT4052 4-CHANNEL MULTIPLEXR on Main Board or Filter Board 74HCT4052 can be located SCL SDA 3.3V+ GND INT/BAND FUT Filter Plug Green Orange Yellow White Red Black 3.3V P09-SCL P08-SDA Yellow White P22-SCL P21-SDA BAND INTGND using PCF8574 P27 becomes INT. network P27 becomes BAND. When NOTE: When using Analog Resistor ROTARY SWITCH BAND SELECTOR COM80m 40m 20m 15m10m 1.1 K 1.1 K 1.0 K 820 3.6 K 560 P27 BAND 5V ANALOG RESISTOR MATRIXused in lieu of PCF8574 Optional Resistor Matrix can be

9 VFO input to Radio or External VFO in W/O Wire +9.2V To Radio Plug Yellow Yellow Wire Splice

SKETCH FOR ATLAS 210x DIGITAL VFO (DDS) ESP32 DEVKIT C 06/29/22 by John Satterfield - KI5IDZ ESP32 DEVKIT C - VER 4.2.1 04/08/25 by KI5IDZ

215D1 D0 CLK 3V3 ENVPVN343533252627141213D2 D3 GND32 CMD 5V ESP32-DevkitC 3.3V GND SCLK SCK ESP32-DevkitC SCAN MOSI CSRS/DC 3.3V INT CLOCK cw MUX1 MUX0 LOCK MEM DT(A) CLK(B) STEP BUP BDOWN TSCL TSDA OFF 3.3V P7 PCF8574 101112131415Vcc 6

B 128 p/rev Rotary Enc. GND OUTSIDE RADIO LOOKING AT SOCKET 3.3V Set Count to 20 + BRW

Y P03 Yellow GND Encoder Plug P05 A Black Red White Black Red White Yellow
