JohnWSatterfield/VFO4.1.1/Sketch/VFO4.2.1 9.62 S3 S3R8.pdf

B
R

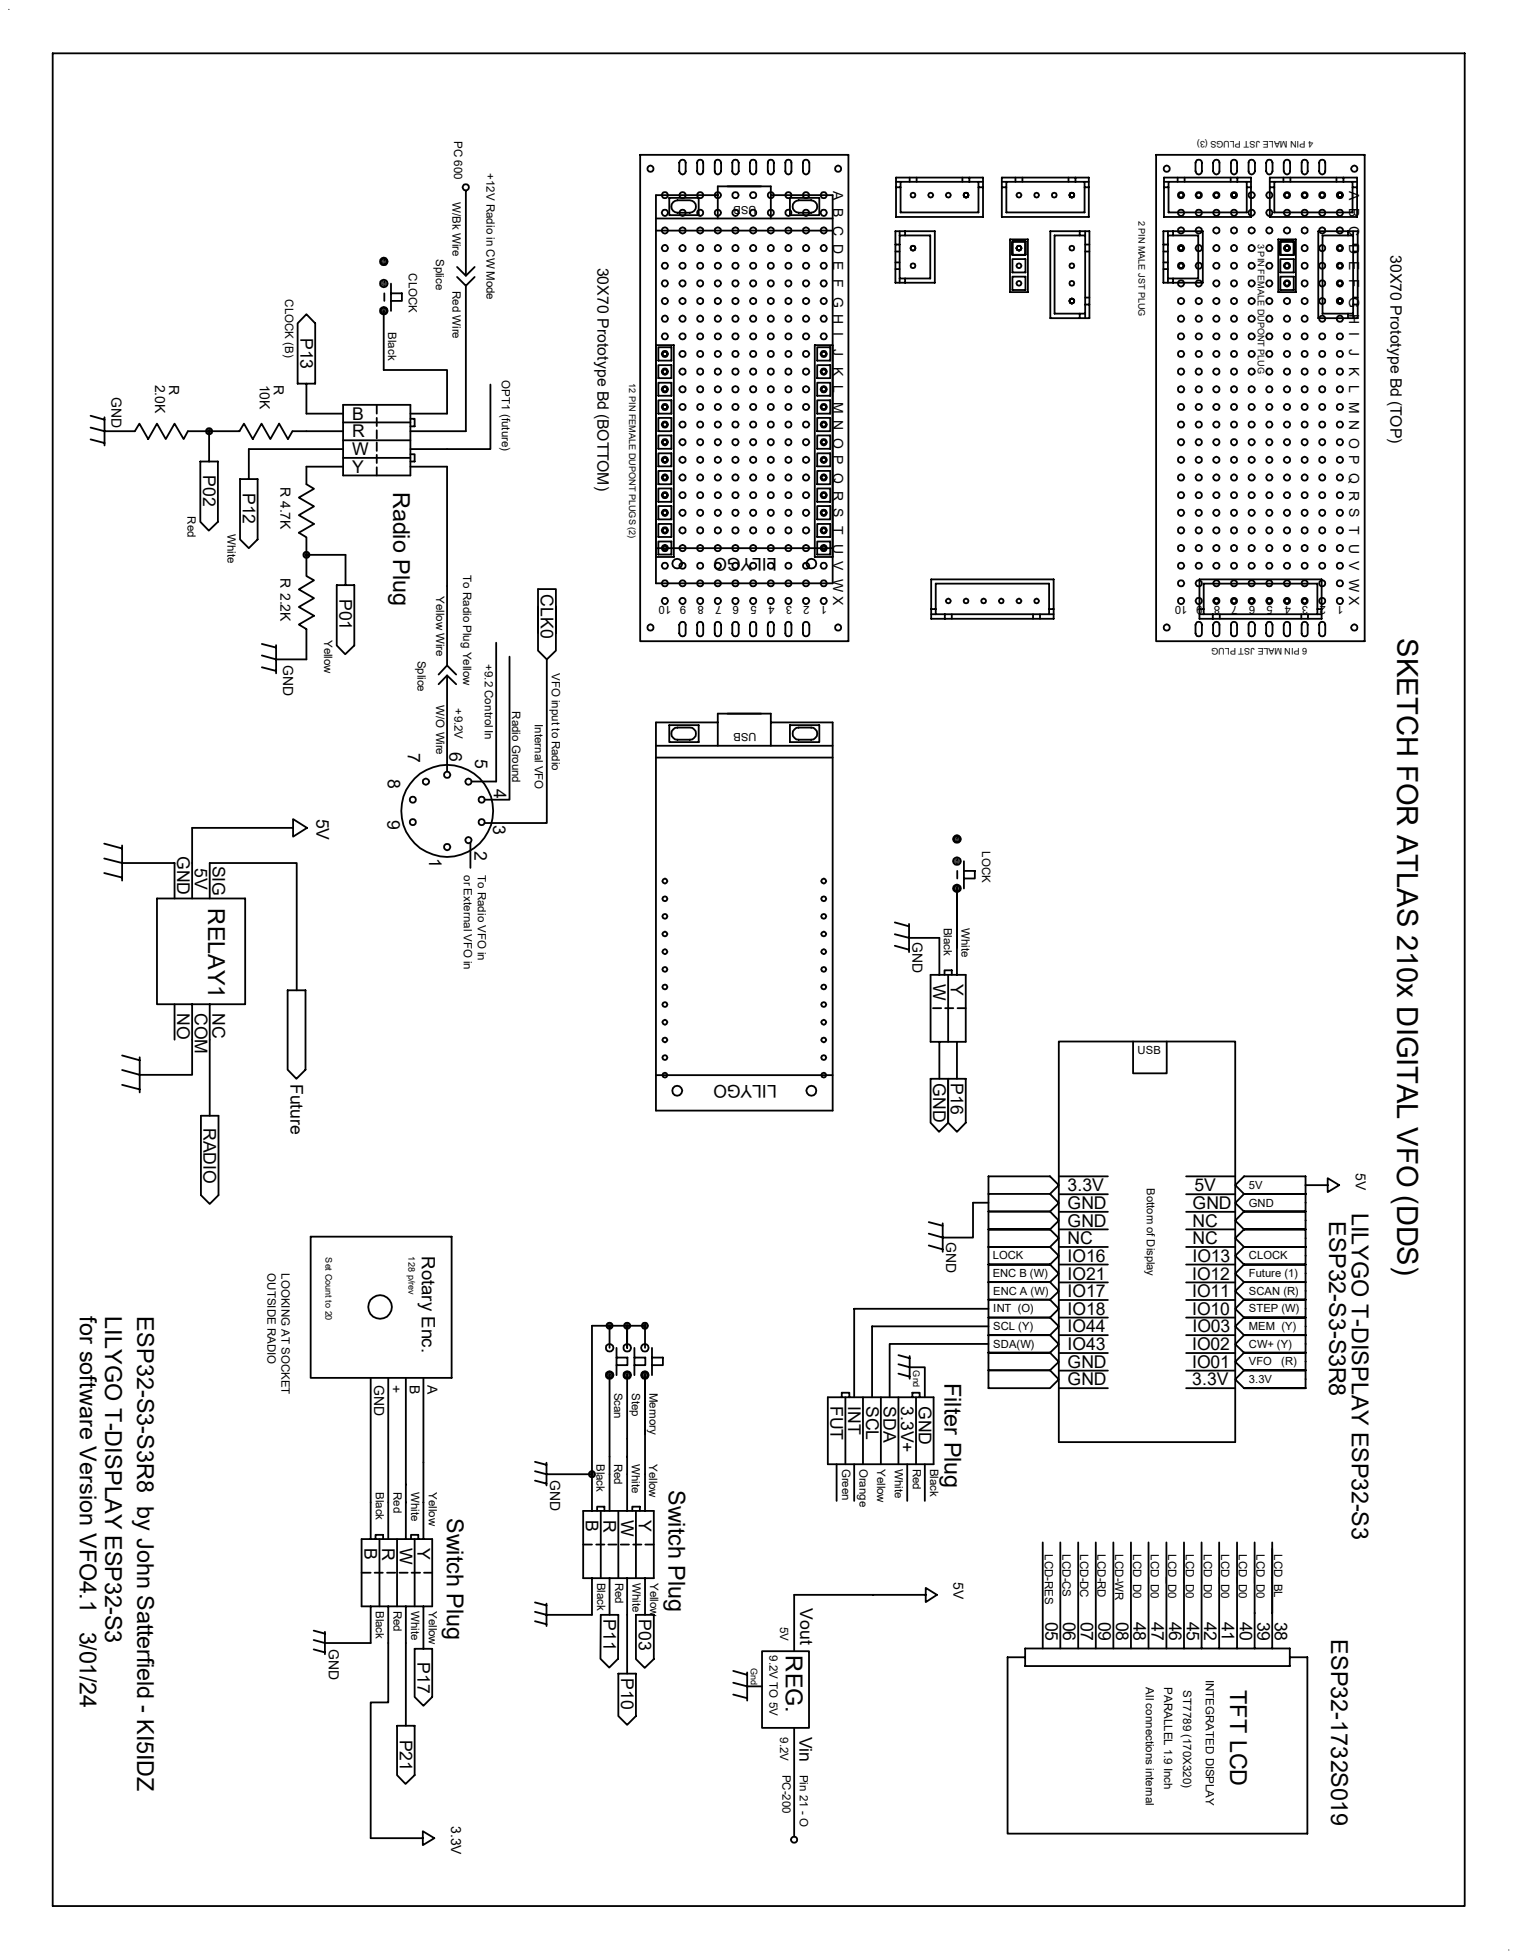
[picture p15: page 1]

Y LOCK P16 Black White GND GND CLOCK Black

8 OUTSIDE RADIO LOOKING AT SOCKET Internal VFO Radio Ground +9.2 Control In CLK0 To Radio VFO in LILYGO T-DISPLAY ESP32-S3 3.3V 2.0K R GND for software Version VFO4.1 3/01/24 Set Count to 20

Y Filter Plug Radio Plug Scan Step Memory GND P03 YellowSwitch Plug P10 P11 BRW

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

B 128 p/rev Rotary Enc. GND

Y P17 Yellow GND Switch Plug P21 Black Red White A Black Red White Black Red White Yellow Black Red White Yellow FUT INT SCL SDA 3.3V+ GND Red Black Gnd Green Orange Yellow White
